htfab/tt07-fprn/docs/fprn-presentation.pdf

Field Programmable Resistor Network https://github.com/htfab/tt07-fprn

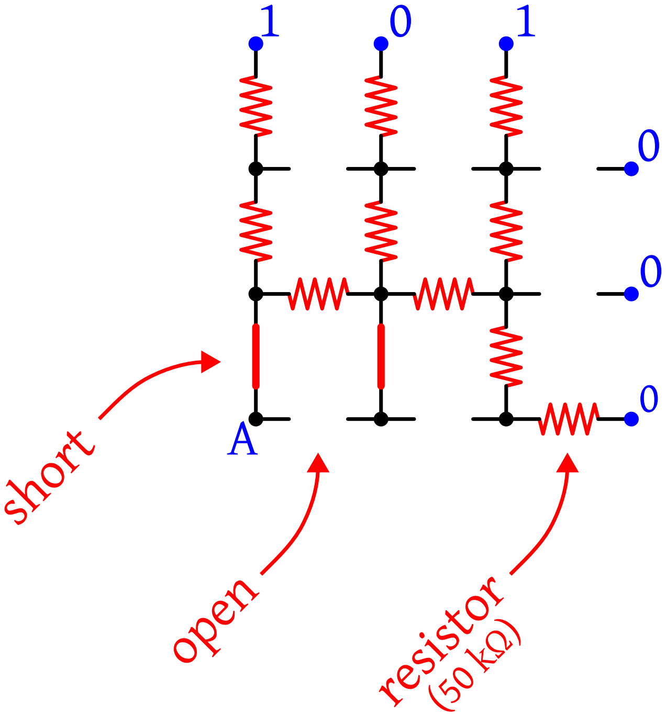
[picture p1: figure]
resistor (50 kΩ); short; open

Field Programmable Resistor Network https://github.com/htfab/tt07-fprn

danger level

⚠

medium
=
some
congurations
short digital
input pins
+
powers up
with an
unknown
conguration

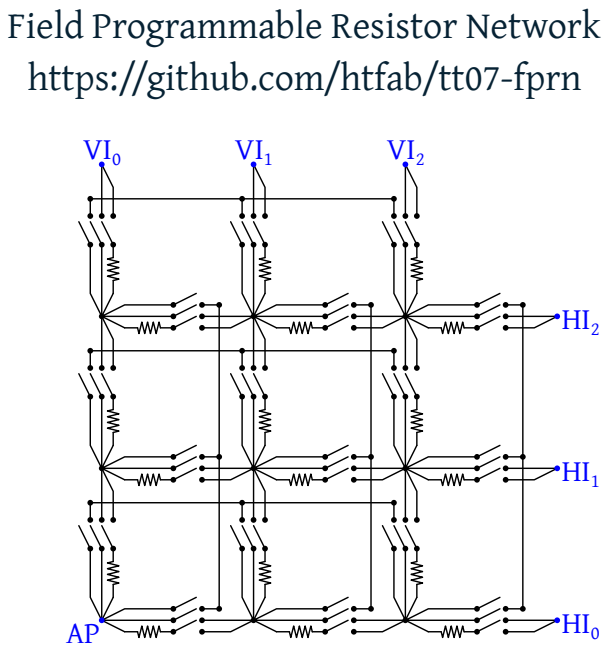
[picture p2: page 3]

Field Programmable Resistor Network
https://github.com/htfab/tt07-fprn

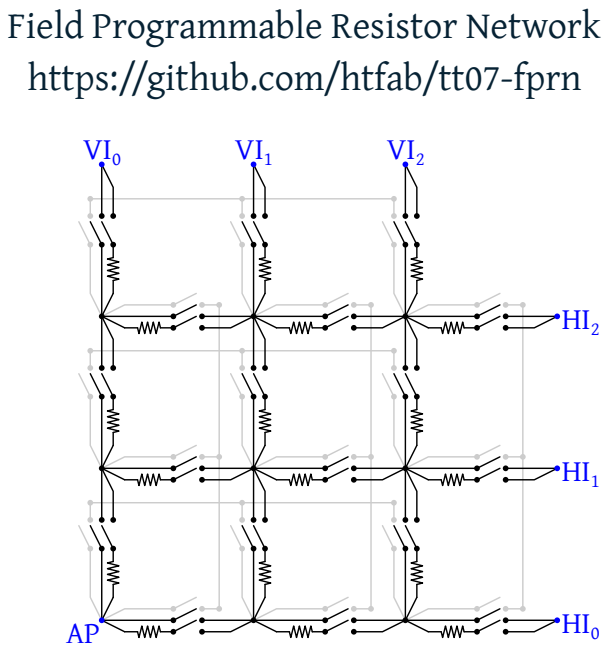
[picture p3: page 4]

Field Programmable Resistor Network
https://github.com/htfab/tt07-fprn

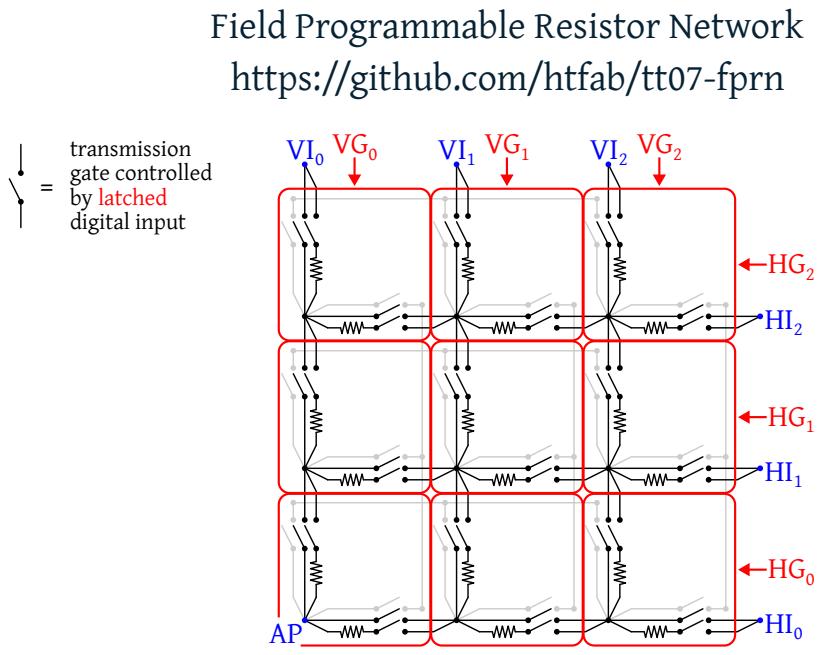
[picture p4: page 5]
transmission gate controlled by latched digital input

Field Programmable Resistor Network
https://github.com/htfab/tt07-fprn

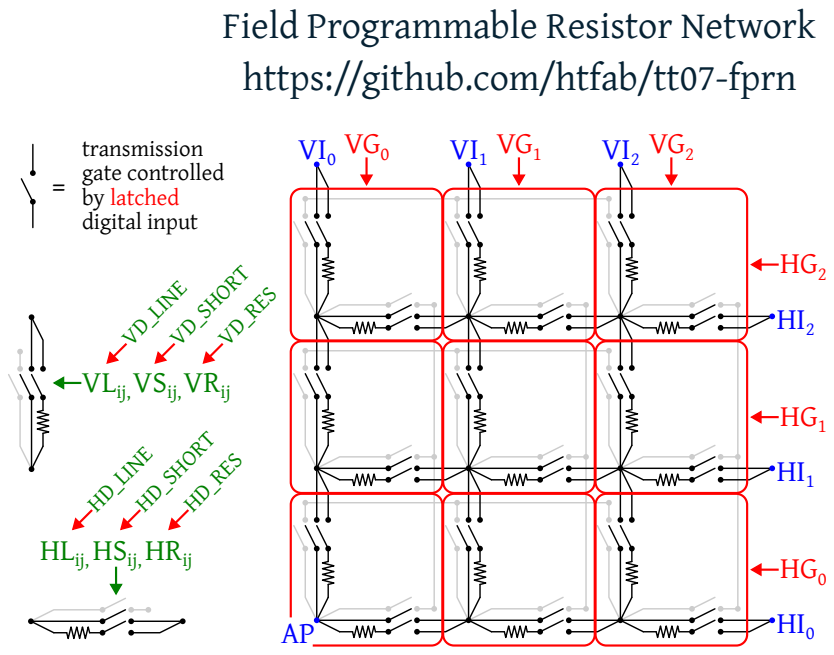
[picture p5: page 6]
transmission gate controlled by latched digital input; VD_LINE; VD_SHORT VD_RES; HD_LINE; HD_SHORT HD_RES

Field Programmable Resistor Network
https://github.com/htfab/tt07-fprn

VLij, VSij, VRij

HLij, HSij, HRij

⚠

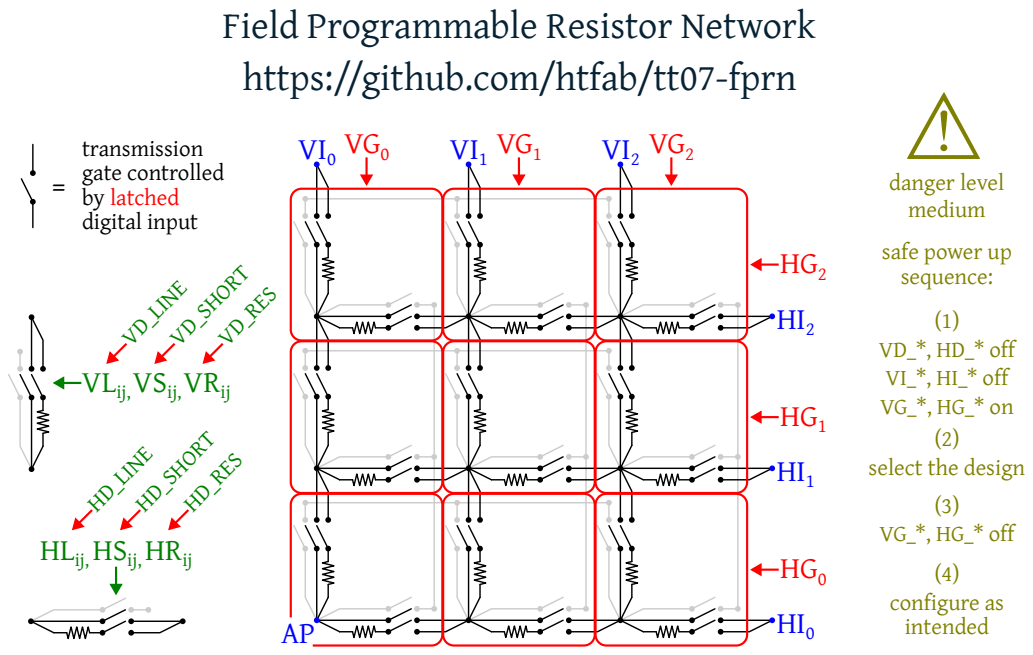
[picture p6: page 7]
transmission gate controlled by latched digital input; VD_LINE; VD_SHORT VD_RES; HD_LINE; HD_SHORT HD_RES; danger level medium safe power up sequence: (1) VD_*, HD_* o VI_*, HI_* o VG_*, HG_* on (2) select the design (3) VG_*, HG_* o (4) congure as intended

Field Programmable Resistor Network
https://github.com/htfab/tt07-fprn

VLij, VSij, VRij

HLij, HSij, HRij

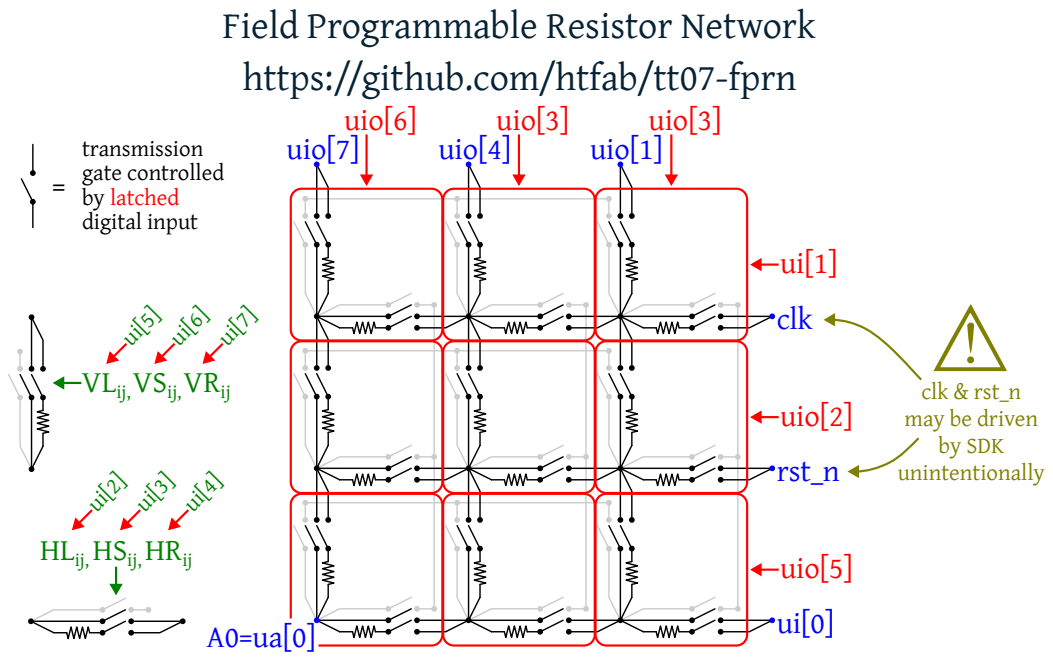
[picture p7: page 8]
rst_n; clk; uio[7]; uio[4]; uio[1]; uio[6]; uio[3]; uio[5]; uio[2]; transmission gate controlled by latched digital input

Field Programmable Resistor Network
https://github.com/htfab/tt07-fprn

VLij, VSij, VRij

clk & rst_n
may be driven
by SDK
unintentionally

HLij, HSij, HRij

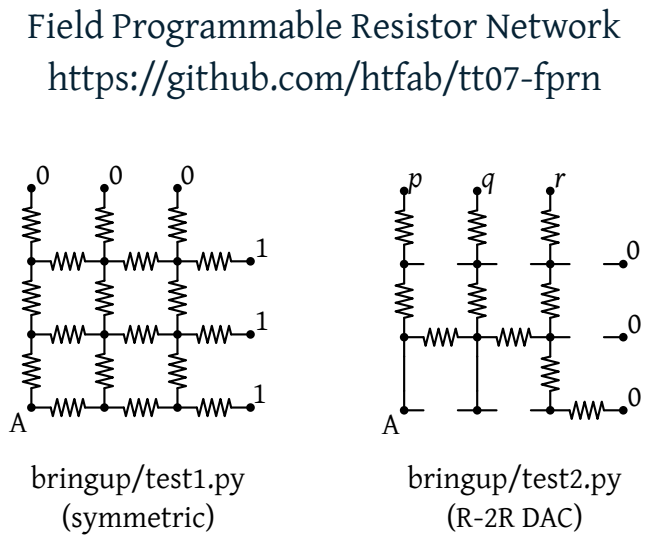
[picture p8: page 9]
bringup/test1.py (symmetric); bringup/test2.py (R-2R DAC)

Field Programmable Resistor Network
https://github.com/htfab/tt07-fprn

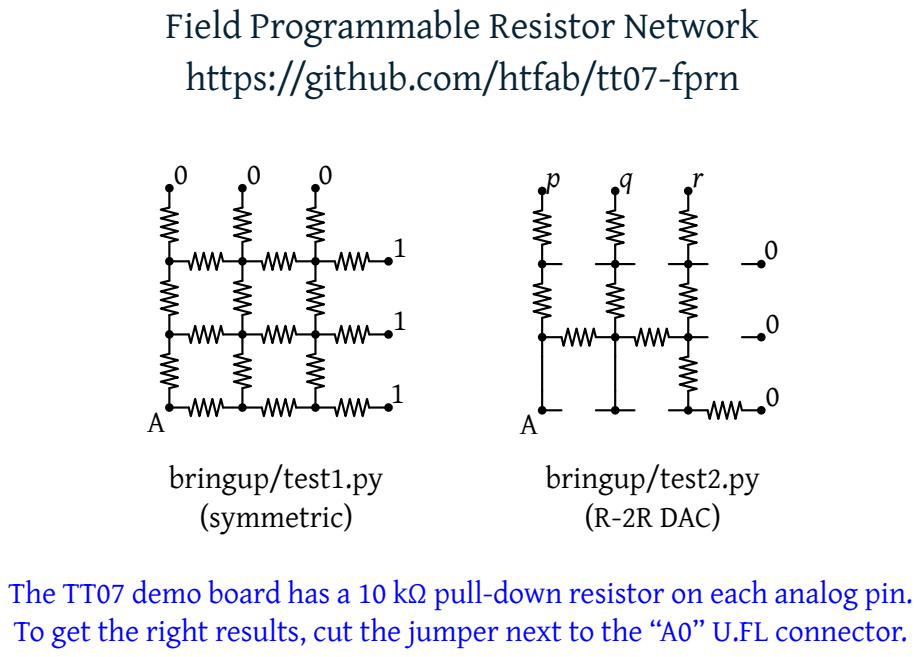
[picture p9: page 10]
bringup/test1.py (symmetric); bringup/test2.py (R-2R DAC)

Field Programmable Resistor Network
https://github.com/htfab/tt07-fprn

The TT07 demo board has a 10 kΩ pull-down resistor on each analog pin.
To get the right results, cut the jumper next to the “A0” U.FL connector.
