htfab/tt07-fprn/netlist/schem/and_gate.spice

** sch_path: /foss/designs/matrix-dac/xschem/and_gate.sch
.subckt and_gate VDD OUT A B VSS
*.PININFO VSS:B VDD:B A:I OUT:O B:I
x1 VDD A net1 B VSS nand_gate
x2 VDD net1 OUT VSS inverter
.ends

* expanding   symbol:  nand_gate.sym # of pins=5
** sym_path: /foss/designs/matrix-dac/xschem/nand_gate.sym
** sch_path: /foss/designs/matrix-dac/xschem/nand_gate.sch
.subckt nand_gate VDD A OUT B VSS
*.PININFO VSS:B VDD:B B:I OUT:O A:I
XM2 net1 B VSS VSS sky130_fd_pr__nfet_g5v0d10v5 L=0.5 W=0.65 nf=1 ad='int((nf+1)/2) * W/nf * 0.29' as='int((nf+2)/2) * W/nf * 0.29'
+ pd='2*int((nf+1)/2) * (W/nf + 0.29)' ps='2*int((nf+2)/2) * (W/nf + 0.29)' nrd='0.29 / W' nrs='0.29 / W' sa=0 sb=0 sd=0 mult=1 m=1
XM3 OUT A VDD VDD sky130_fd_pr__pfet_g5v0d10v5 L=0.5 W=1 nf=1 ad='int((nf+1)/2) * W/nf * 0.29' as='int((nf+2)/2) * W/nf * 0.29' pd='2*int((nf+1)/2) * (W/nf + 0.29)'
+ ps='2*int((nf+2)/2) * (W/nf + 0.29)' nrd='0.29 / W' nrs='0.29 / W' sa=0 sb=0 sd=0 mult=1 m=1
XM1 OUT A net1 VSS sky130_fd_pr__nfet_g5v0d10v5 L=0.5 W=0.65 nf=1 ad='int((nf+1)/2) * W/nf * 0.29' as='int((nf+2)/2) * W/nf * 0.29'
+ pd='2*int((nf+1)/2) * (W/nf + 0.29)' ps='2*int((nf+2)/2) * (W/nf + 0.29)' nrd='0.29 / W' nrs='0.29 / W' sa=0 sb=0 sd=0 mult=1 m=1
XM4 OUT B VDD VDD sky130_fd_pr__pfet_g5v0d10v5 L=0.5 W=1 nf=1 ad='int((nf+1)/2) * W/nf * 0.29' as='int((nf+2)/2) * W/nf * 0.29' pd='2*int((nf+1)/2) * (W/nf + 0.29)'
+ ps='2*int((nf+2)/2) * (W/nf + 0.29)' nrd='0.29 / W' nrs='0.29 / W' sa=0 sb=0 sd=0 mult=1 m=1
.ends


* expanding   symbol:  inverter.sym # of pins=4
** sym_path: /foss/designs/matrix-dac/xschem/inverter.sym
** sch_path: /foss/designs/matrix-dac/xschem/inverter.sch
.subckt inverter VDD IN OUT VSS
*.PININFO VSS:B VDD:B IN:I OUT:O
XM1 OUT IN VSS VSS sky130_fd_pr__nfet_g5v0d10v5 L=0.5 W=0.65 nf=1 ad='int((nf+1)/2) * W/nf * 0.29' as='int((nf+2)/2) * W/nf * 0.29'
+ pd='2*int((nf+1)/2) * (W/nf + 0.29)' ps='2*int((nf+2)/2) * (W/nf + 0.29)' nrd='0.29 / W' nrs='0.29 / W' sa=0 sb=0 sd=0 mult=1 m=1
XM2 OUT IN VDD VDD sky130_fd_pr__pfet_g5v0d10v5 L=0.5 W=1 nf=1 ad='int((nf+1)/2) * W/nf * 0.29' as='int((nf+2)/2) * W/nf * 0.29' pd='2*int((nf+1)/2) * (W/nf + 0.29)'
+ ps='2*int((nf+2)/2) * (W/nf + 0.29)' nrd='0.29 / W' nrs='0.29 / W' sa=0 sb=0 sd=0 mult=1 m=1
.ends

.end
