htfab/tt07-fprn/(commit log)

2024-06-01 add design files to repo
    [and_gate.sch, buffer.sch, decoder_1bit.sch, decoder_2bit.sch, decoder_3bit.sch, grid.sch, grid_cell.sch, grid_row.sch]
2024-06-01 add missing connection
    [tt_um_htfab_fprn.sch]
2025-02-06 make the circuit diagram readable in dark mode
